grgao/boat/Report/main.tex

% define \title (only used by writelatex.com)
%\title{ECE 455 Capstone Design in Electrical and Computer Engineering \\}
%%%%%%%%%%%%%%%%%%%%%%%%%%%%%%%%%%%%%%%%%%%%%%%%%%%%%%%%%%%%%%%%%%%%%%
% LaTeX Template: Project Titlepage
%
% Source: http://www.howtotex.com
% Date: April 2011
% 
% This is a title page template which be used for articles & reports.
% 
% Feel free to distribute this example, but please keep the referral
% to howtotex.com
% 
%%%%%%%%%%%%%%%%%%%%%%%%%%%%%%%%%%%%%%%%%%%%%%%%%%%%%%%%%%%%%%%%%%%%%%
% How to use writeLaTeX: 
%
% You edit the source code here on the left, and the preview on the
% right shows you the result within a few seconds.
%
% Bookmark this page and share the URL with your co-authors. They can
% edit at the same time!
%
% You can upload figures, bibliographies, custom classes and
% styles using the files menu.
%
% If you're new to LaTeX, the wikibook is a great place to start:
% http://en.wikibooks.org/wiki/LaTeX
%
%%%%%%%%%%%%%%%%%%%%%%%%%%%%%%%%%%%%%%%%%%%%%%%%%%%%%%%%%%%%%%%%%%%%%%
%
% --------------------------------------------------------------------
% Preamble
% --------------------------------------------------------------------
\documentclass[ fontsize=11pt,twoside]{scrartcl}	% KOMA

\usepackage[letterpaper,pdftex]{geometry}	% A4paper margins
\setlength{\oddsidemargin}{5mm}			% Remove 'twosided' indentation
\setlength{\evensidemargin}{5mm}

\usepackage[english]{babel}
\usepackage[protrusion=true,expansion=true]{microtype}	
\usepackage{amsmath,amsfonts,amsthm,amssymb}
\usepackage{graphicx}
\usepackage{pseudocode}
\usepackage{siunitx}				% SI units
\usepackage{hyperref}

\usepackage[utf8]{inputenc}      % Use UTF-8 encoding
\usepackage[T1]{fontenc}         % Use modern font encoding
\usepackage{lmodern}             % Use scalable Latin Modern fonts
\usepackage{microtype}           % Enables font expansion
\usepackage{tikz}
\usepackage{float}
\usepackage{listings}
\usepackage{xcolor}
\usepackage{longtable}

\lstset{
    basicstyle=\ttfamily\small,
    keywordstyle=\color{blue},
    commentstyle=\color{gray},
    stringstyle=\color{orange},
    frame=single,
    columns=flexible,
    breaklines=true
}
\usetikzlibrary{shapes,arrows}

% --------------------------------------------------------------------
% Definitions (do not change this)
% --------------------------------------------------------------------
\newcommand{\HRule}[1]{\rule{\linewidth}{#1}} 	% Horizontal rule

\makeatletter							% Title
\def\printtitle{%						
    {\centering \@title\par}}
\makeatother									

\makeatletter							% Author
\def\printauthor{%					
    {\centering \Large \@author}}				
\makeatother							

% --------------------------------------------------------------------
% Metadata (Change this)
% --------------------------------------------------------------------
\title{	\Large \textsc{ECE 455 Capstone Design in Electrical and Computer Engineering   \\
															Project Report} 	% Subtitle
		 	\\[2.0cm]								% 2cm spacing
			\HRule{2pt} \\						% Upper rule
			\LARGE \textbf{\uppercase{Low-Frequency Electromagnetic Emitting Autonomous Boat for Offshore Plane Wreckage Recovery}}	% Title
			\HRule{2pt} \\ [0.5cm]		% Lower rule + 0.5cm spacing
			\Large \today			% Todays date
		}

 \author{
		Grace Gao\\	
        Gavin McGowan\\
        Miles Gansho\\
		Esh K\\
		Department of Electrical and Computer Engineering\\	
        College of Engineering \\
		University of Wisconsin-Madison\\
        }

\begin{document}
% ------------------------------------------------------------------------------
% Maketitle
% ------------------------------------------------------------------------------
\thispagestyle{empty}		% Remove page numbering on this page

\printtitle					% Print the title data as defined above
  	\vfill
\printauthor				% Print the author data as defined above
\newpage
% ------------------------------------------------------------------------------
% Begin document
% ------------------------------------------------------------------------------
\setcounter{page}{1}		% Set page numbering to begin on this page

%%%%%%%%%%%%%%%
%														%
% 			Main Contents            %
%														%
%%%%%%%%%%%%%%%

\input{Introduction}
\input{BillofMaterials}
\input{Circuit_schem}
\input{Hardware}
\input{Electrical}
\input{Coding}
\input{Operating Instructions}
\input{Troubleshooting} 
\input{FutureWork}

\clearpage
\appendix
\input{appendix}

% ------------------------------------------------------------------------------
% End document
% ------------------------------------------------------------------------------
\end{document}
