grgao/boat/Report/appendix.tex

\section{Isometric Views of all 3D-Printed Parts}

\begin{figure}[htbp]
    \centering
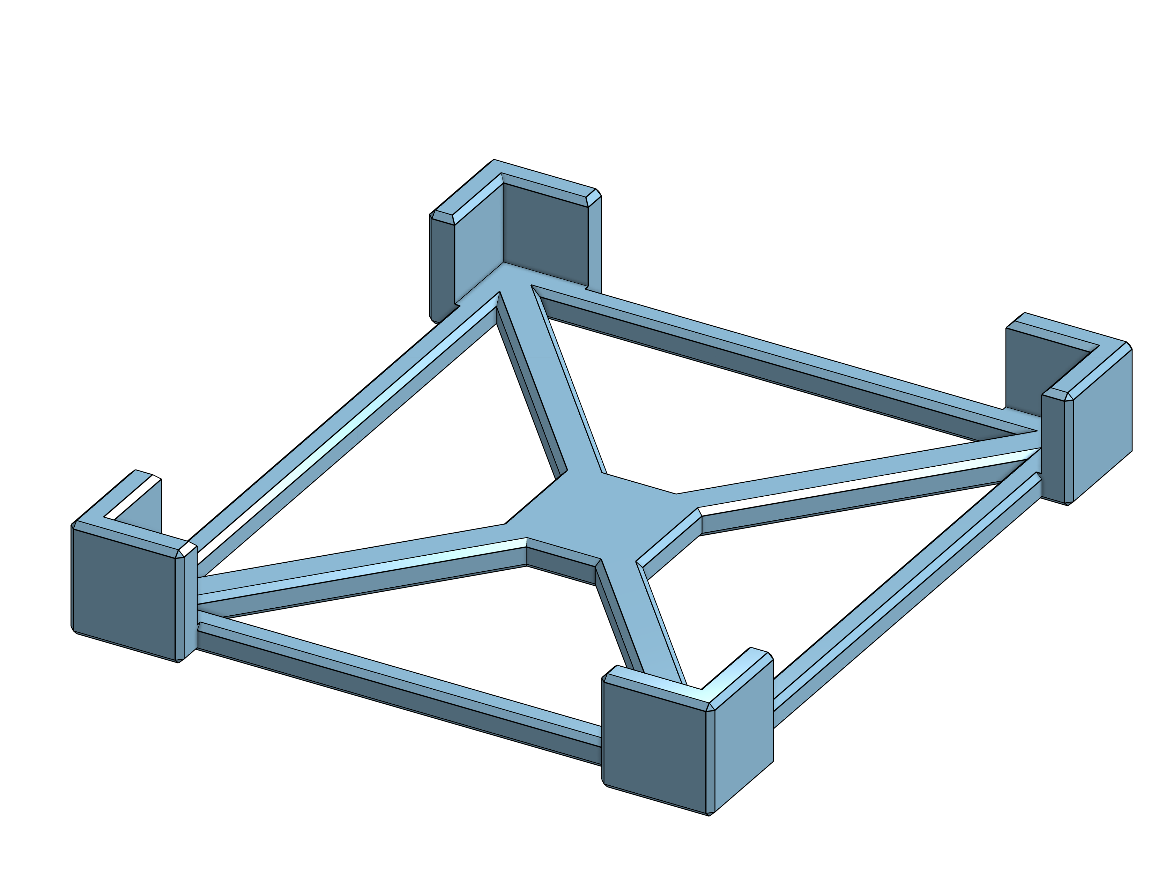
[picture p6: Report/Battery_Base.png]
    
    \caption{Base to hold batteries in place.}
    \label{fig:battery-base}
\end{figure}

\begin{figure}[htbp]
    \centering
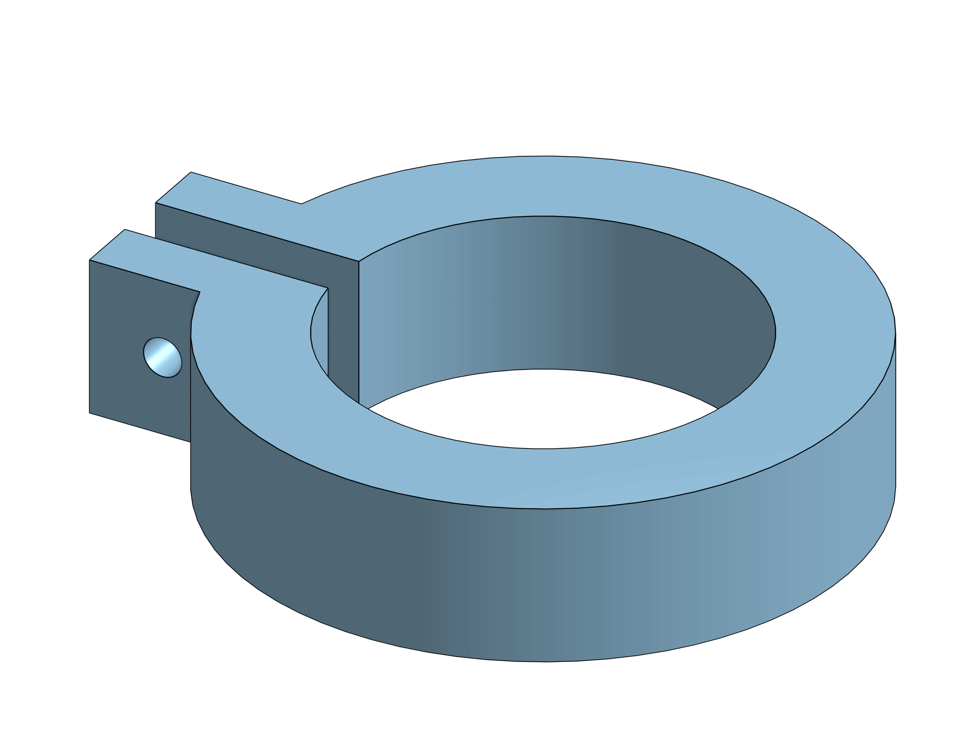
[picture p7: Report/Clamp.png]
    
    \caption{Bushing that clamps to PVC.}
    \label{fig:clamp}
\end{figure}

\begin{figure}[htbp]
    \centering
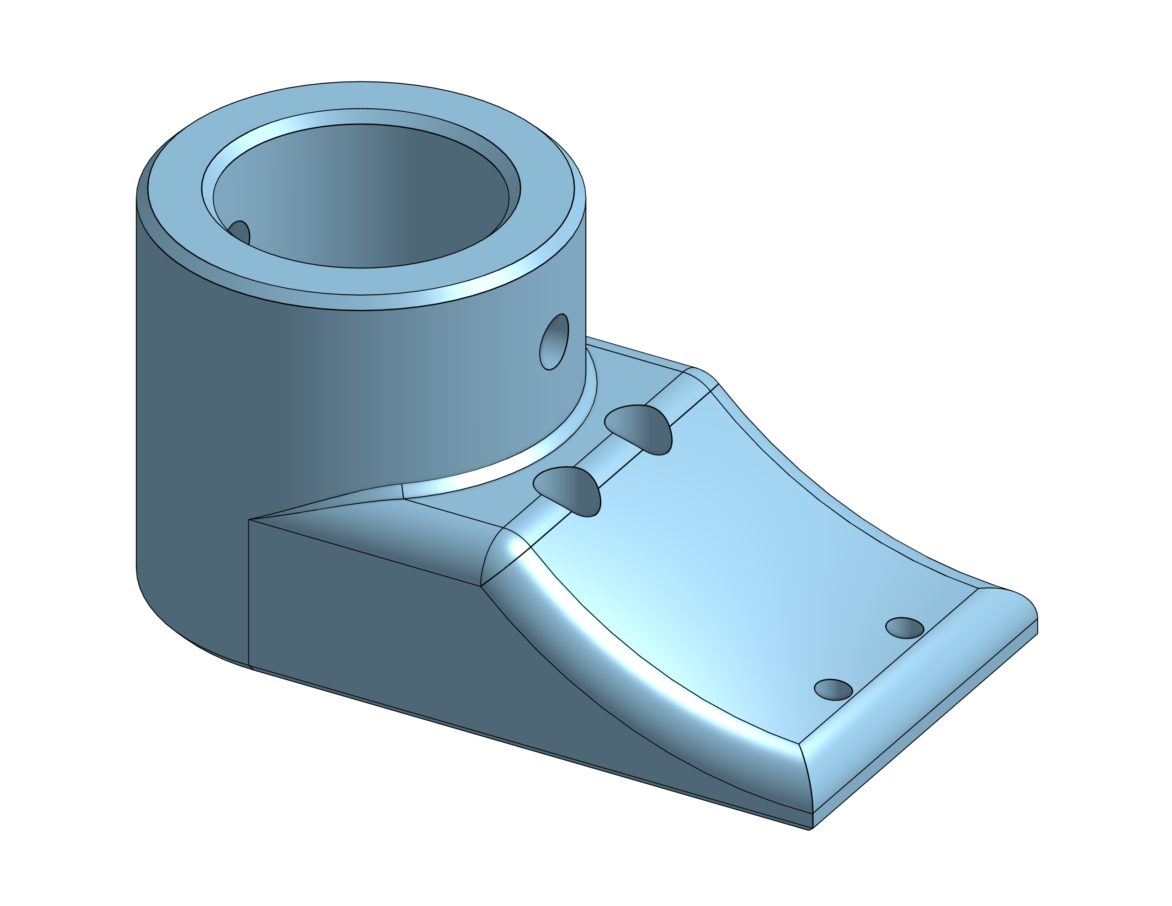
[picture p8: Report/Motor_to_PVC.png]
    
    \caption{Motor to PVC attachment.}
    \label{fig:motor-to-pvc}
\end{figure}

\begin{figure}[htbp]
    \centering
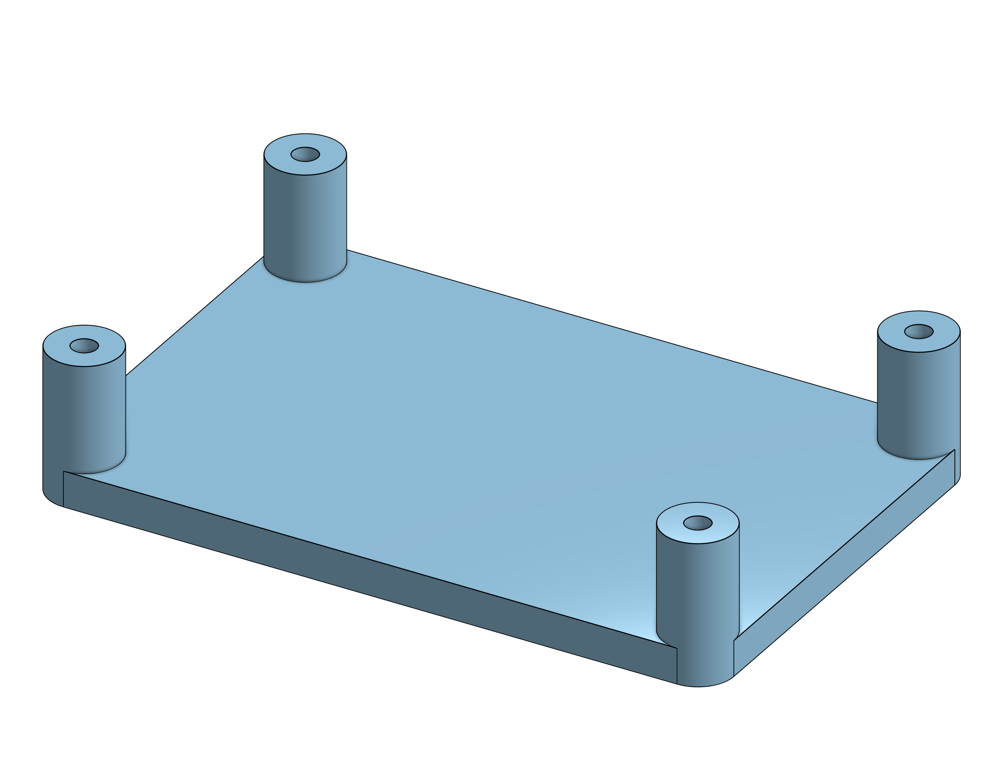
[picture p9: Report/Perfboard_Mounting.png]
    
    \caption{Base for perfboard to mount to with M2 screws.}
    \label{fig:perfboard-mounting}
\end{figure}

\begin{figure}[htbp]
    \centering
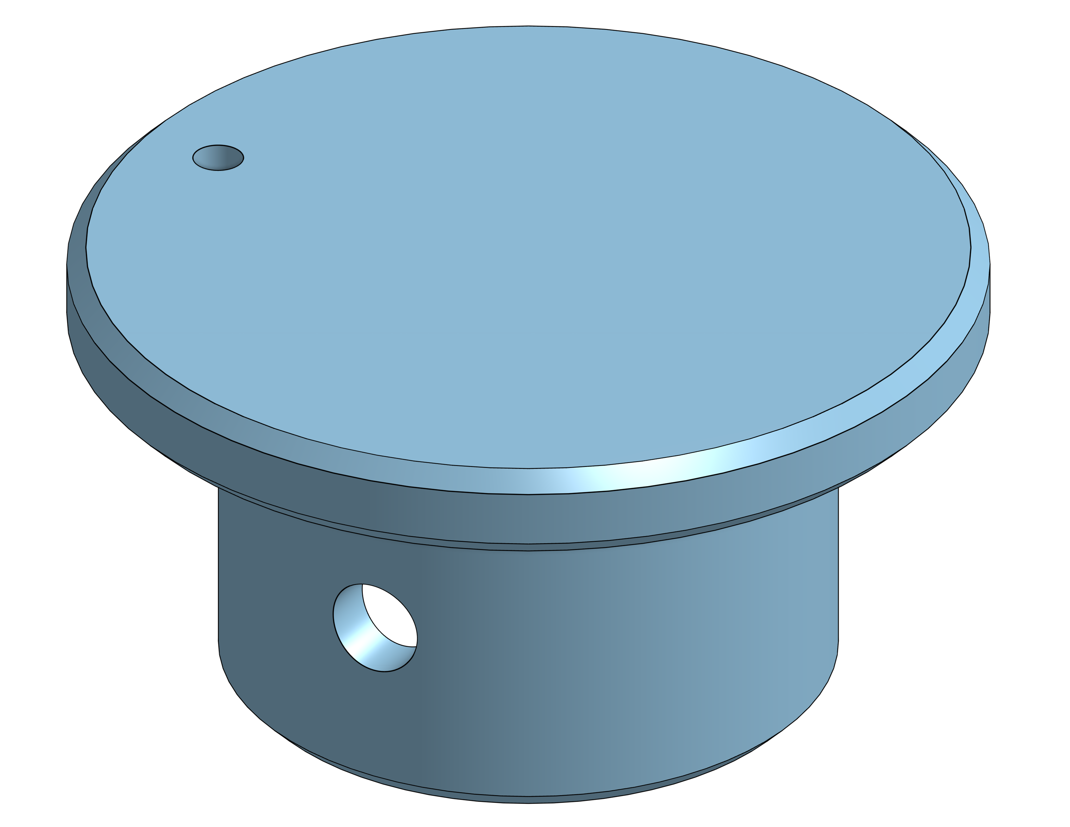
[picture p10: Report/Servo_to_PVC.png]
    
    \caption{Servo to PVC attachment to align axis of rotation.}
    \label{fig:servo-to-pvc}
\end{figure}
