grgao/boat/Report/Simulations and Circuit Board Design.tex

\section{Simulation and Circuit Board Design}
Include URL links to any circuit simulation or PCB design files. You can store them on a folder in OneDrive. \textbf{Please add me as an owner so I can access the files after your account closes.}
