grgao/boat/Report/Power_Diagram.png

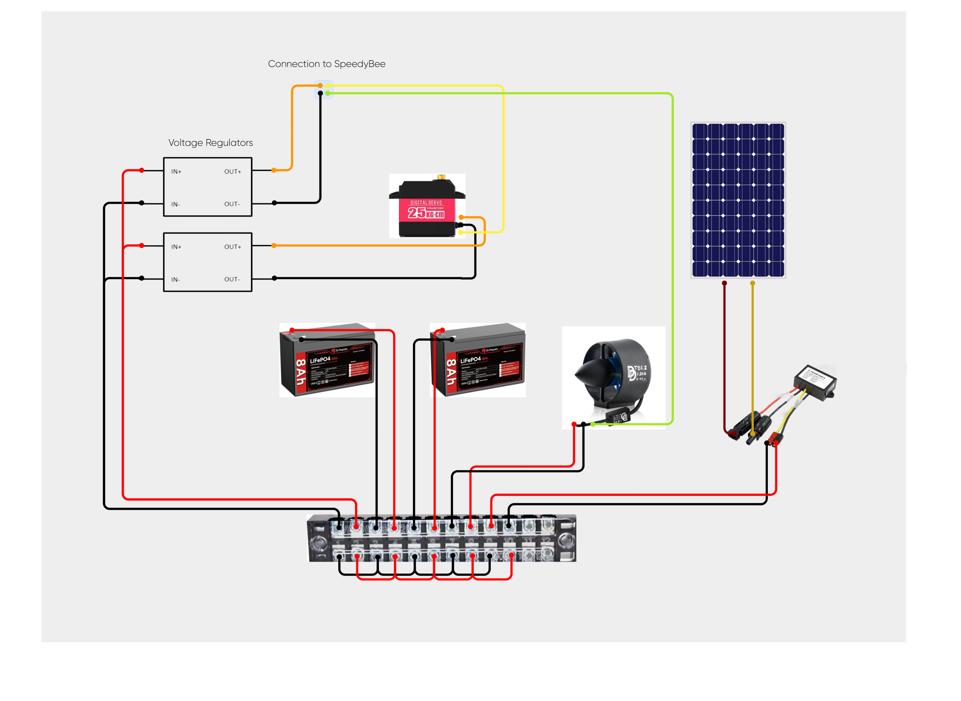
Report/Power_Diagram.png
