grgao/boat/Report/PVC.jpg

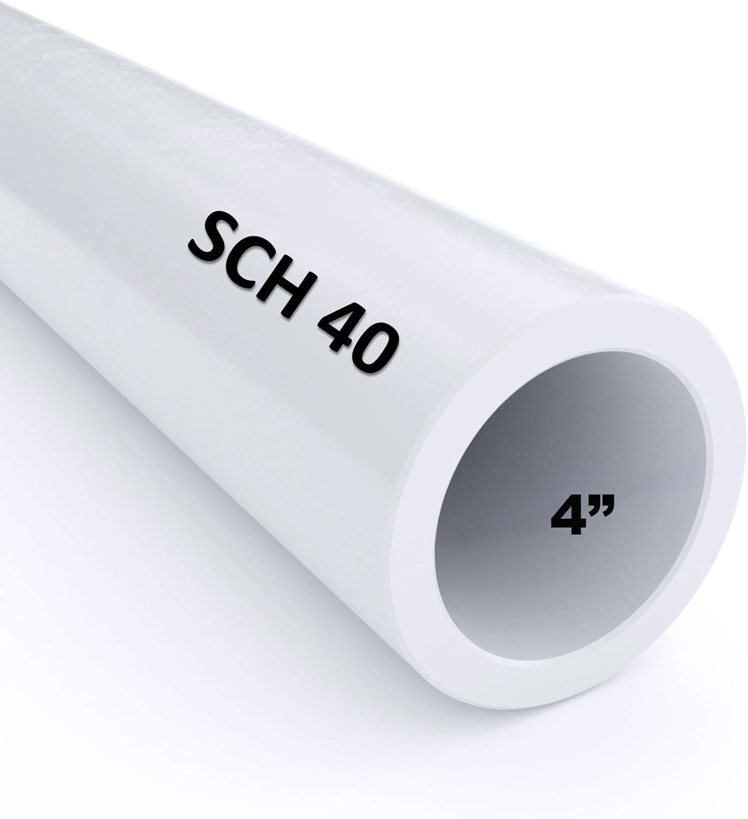
Report/PVC.jpg
