grgao/boat/Report/BillofMaterials.tex

\section{Bill of Materials}
\begin{table}[H]
    \centering
    \begin{tabular}{|l|l|l|l|}
    \hline
        Item & Price/unit & Quantity & Total Price \\ \hline
        18AWG wire & \$0.00 & 702 ft & \$0.00 \\ \hline
        PVC Pipe 1" & \$0.00 & 1 & \$0.00 \\ \hline
        PVC Pipe 4" & \$0.00 & 2 & \$0.00 \\ \hline
        PVC cement & \$0.00 & 1 & \$0.00 \\ \hline
        PVC caps (2 pack) & \$14.99 & 2 & \$29.98 \\ \hline
        Underwater Motor & \$67.52 & 1 & \$67.52 \\ \hline
        Servo & \$13.99 & 1 & \$13.99 \\ \hline
        SpeedyBee & \$65.00 & 1 & \$65.00 \\ \hline
        Amplifier & \$9.00 & 1 & \$9.00 \\ \hline
        Transmitter / Reciever & \$50.00 & 1 & \$50.00 \\ \hline
        100W Solar Panel & \$70.00 & 1 & \$70.00 \\ \hline
        Battery & \$22.00 & 2 & \$44.00 \\ \hline
        MPPT Charger & \$42.00 & 1 & \$42.00 \\ \hline
        Acrylic & \$40.00 & 0 & \$0.00 \\ \hline
        Electronic Box & \$31.00 & 1 & \$31.00 \\ \hline
        Filament Roll & \$20.00 & 1 & \$20.00 \\ \hline
        PolyCarbonate & \$0.00 & 1 & \$0.00 \\ \hline
        Signal Generator & \$7.99 & 1 & \$7.99 \\ \hline
        GPS & \$18.00 & 1 & \$18.00 \\ \hline
        EPS Foam & \$0.00 & 1 & \$0.00 \\ \hline
        1/4" inch bolt  & \$0.00 & 14 & \$0.00 \\ \hline
        1/4" nut & \$0.00 & 20 & \$0.00 \\ \hline
        Washer & \$0.10 & 20 & \$2.00 \\ \hline
        1/2" Fiber glass composite rods & \$0.00 & 4 & \$0.00 \\ \hline
        HDF wood & \$3.75 & 1 & \$3.75 \\ \hline
        M3 Screw & \$0.35 & 2 & \$0.70 \\ \hline
        Long bolt  & \$0.00 & 4 & \$0.00 \\ \hline
        L7805CV & \$0.00 & 2 & \$0.00 \\ \hline
        Capacitors & \$0.00 & 12 & \$0.00 \\ \hline
        WM8672-ND & \$1.36 & 1 & \$1.36 \\ \hline
        732-10955-ND & \$0.36 & 2 & \$0.72 \\ \hline
        296-43663-1-ND & \$0.90 & 2 & \$1.80 \\ \hline
        445-174398-1-ND & \$0.32 & 2 & \$0.64 \\ \hline
        Total Price of ASV & ~ & ~ & \$479.45 \\ \hline
    \end{tabular}
\end{table}

The bill of materials includes what is actually used on the ASV. This doesn't include the cost of a few purchased items that were never used, such as an acrylic base. It also does not include the costs of materials that were given to us for free, such as the PVC pipe. An Excel sheet of the BOM can be found in the repository, including links to all purchased items. The total cost of the ASV is \$479.45, which is under the \$500 budget.
