grgao/boat/Report/BOM with Links.xlsx

Item | Price/unit | Quantity | Total Price | Link
18AWG wire | $0.00 | 702 ft | $0.00 | https://www.remingtonindustries.com/hook-up-wire/hook-up-wire-18-awg-stranded-solid-10-colors-7-sizes-available/
PVC Pipe 1" | $0.00 | 1 | $0.00 | Acquired at Makerspace
PVC Pipe 4" | $0.00 | 2 | $0.00 | Acquired at Makerspace
PVC cement | $0.00 | 1 | $0.00 | Acquired at Makerspace
PVC caps | $14.99 | 2 | $29.98 | https://www.homedepot.com/p/NDS-PVC-S-D-Cap-4-in-4P06/100172701
Underwater Motor | $67.52 | 1 | $67.52 | https://www.amazon.com/dp/B09BVKKKTJ?ref_=ppx_hzsearch_conn_dt_b_fed_asin_title_1
Servo | $13.99 | 1 | $13.99 | https://www.amazon.com/DIAMONDDYNAMICS-Underwater-bi-Directional-Photography-Exploration/dp/B09BVKB3KD
SpeedyBee | $65.00 | 1 | $65.00 | https://www.getfpv.com/speedybee-f405-v4-stack-f4-v4-fc-55a-blheli-s-esc-30x30.html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
Amplifier | $9.00 | 1 | $9.00 | https://www.amazon.com/EPLZON-MPU-6050-Accelerometer-Gyroscope-Converter/dp/B09TVYVC6X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
Transmitter / Reciever | $50.00 | 1 | $50.00 | https://www.amazon.com/dp/B0744DPPL8?ref_=ppx_hzsearch_conn_dt_b_fed_asin_title_1
100W Solar Panel | $70.00 | 1 | $70.00 | https://www.amazon.com/MARBERO-30W-Portable-Solar-Panel-Foldable-Solar-Charger-Generator-Camping-Outdoor-Adventures/dp/B0C58KPMVT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
Battery | $22.00 | 2 | $44.00 | https://www.amazon.com/dp/B0CLGZMHVG?ref_=ppx_hzsearch_conn_dt_b_fed_asin_title_2&th=1
MPPT Charger | $42.00 | 1 | $42.00 | https://www.amazon.com/dp/B087ZSY8CR?ref_=ppx_hzsearch_conn_dt_b_fed_asin_title_1
Electronic Box | $31.00 | 1 | $31.00 | https://www.amazon.com/dp/B08TRQBMCX?ref_=ppx_hzsearch_conn_dt_b_fed_asin_title_1
Filament Roll | $20.00 | 1 | $20.00 | https://www.amazon.com/eSUN-Filament-Dimensional-Accuracy-Printing/dp/B0BN4Y1G2S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
PolyCarbonate | $0.00 | 1 | $0.00 | Acquired at Makerspace
Signal Generator | $7.99 | 1 | $7.99 | https://www.amazon.com/NOYITO-Generator-Frequency-Triangle-Waveform/dp/B07BJHXML4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
GPS | $18.00 | 1 | $18.00 | https://www.amazon.com/dp/B0CB5N8RQ8?ref_=ppx_hzod_title_dt_b_fed_asin_title_0_0
EPS Foam | $0.00 | 1 | $0.00 | Acquired at Makerspace
1/4 inch bolt | $0.00 | 14 | $0.00 | Acquired at Makerspace
1/4 nut | $0.00 | 20 | $0.00 | Acquired at Makerspace
Washer | $0.10 | 20 | $2.00 | Acquired at Makerspace
1/2" Fiber glass composite rods | $0.00 | 4 | $0.00 | Acquired at Makerspace
HDF wood | $3.75 | 1 | $3.75 | Acquired at Makerspace
M3 Screw | $0.35 | 2 | $0.70 | Acquired at Makerspace
Long bolt | $0.00 | 4 | $0.00 | Acquired at Engineer Center Building
L7805CV | $0.00 | 2 | $0.00 | Acquired at Makerspace/Thompson |  | Acquired at Makerspace/Thompson
Capacitors | $0.00 | 12 | $0.00 | Acquired at Makerspace/Thompson |  | Acquired at Makerspace/Thompson
WM8672-ND | $1.36 | 1 | $1.36 | https://www.digikey.com/en/products/detail/molex/1050570001/3045207 | yes | https://www.digikey.com/en/products/detail/molex/1050570001/3045207
732-10955-ND | $0.36 | 2 | $0.72 | https://www.digikey.com/en/products/detail/w%C3%BCrth-elektronik/691137710002/6644051 | yes | https://www.digikey.com/en/products/detail/w%C3%BCrth-elektronik/691137710002/6644051
296-43663-1-ND | $0.90 | 2 | $1.80 | https://www.digikey.com/en/products/detail/texas-instruments/TPS563200DDCR/5034343 | yes | https://www.digikey.com/en/products/detail/texas-instruments/TPS563200DDCR/5034343
445-174398-1-ND | $0.32 | 2 | $0.64 | https://www.digikey.com/en/products/detail/tdk-corporation/VLS5045EX-3R3N/5286683 | yes | https://www.digikey.com/en/products/detail/tdk-corporation/VLS5045EX-3R3N/5286683
Total Price of Boat |  |  | $479.45
