grgao/boat/STEP Files/Solar Panel Bracket pair.step

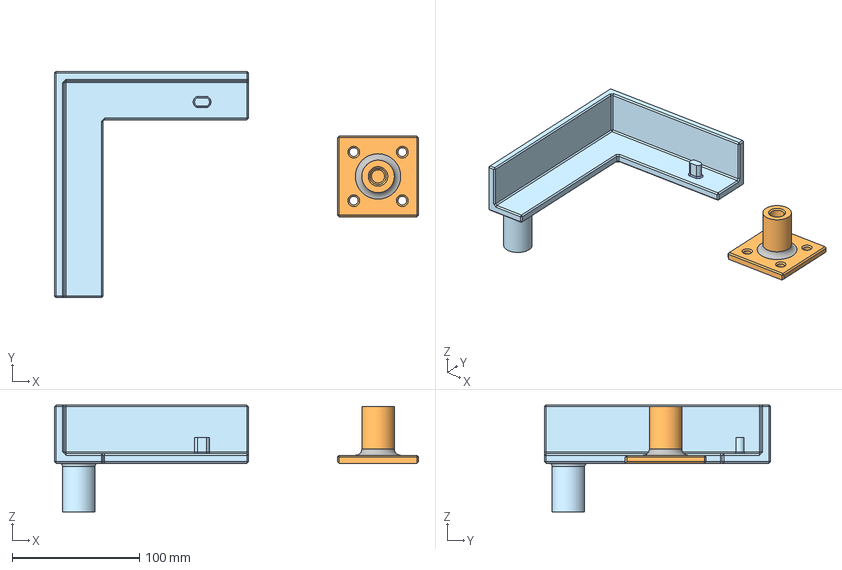
[picture p21: CAD file, 2025-05-11]
STEP Files/Solar Panel Bracket pair.step
285.8 x 177.8 x 83.8 mm
