grgao/boat/STEP Files/Protoboard Mount.step

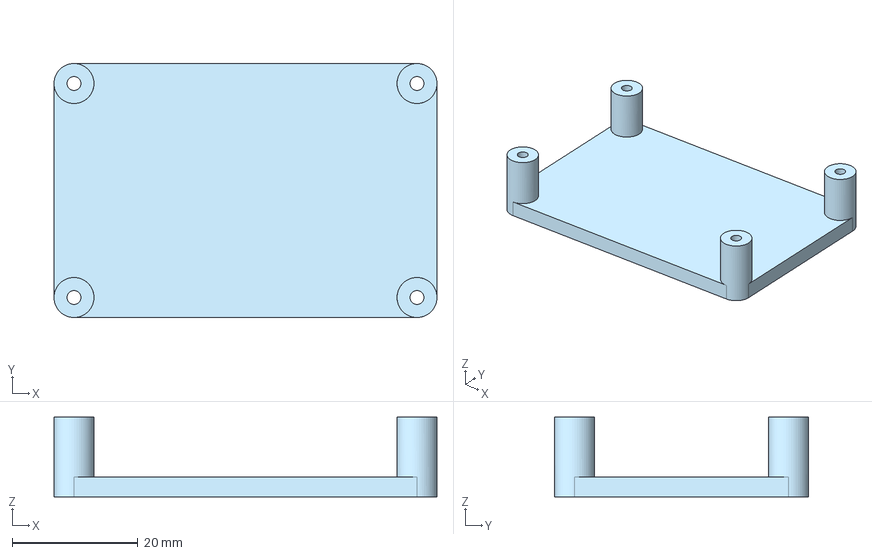
[picture p22: CAD file, 2025-05-11]
STEP Files/Protoboard Mount.step
60.9 x 40.4 x 12.7 mm
