grgao/boat/STEP Files/Servo to PVC.step

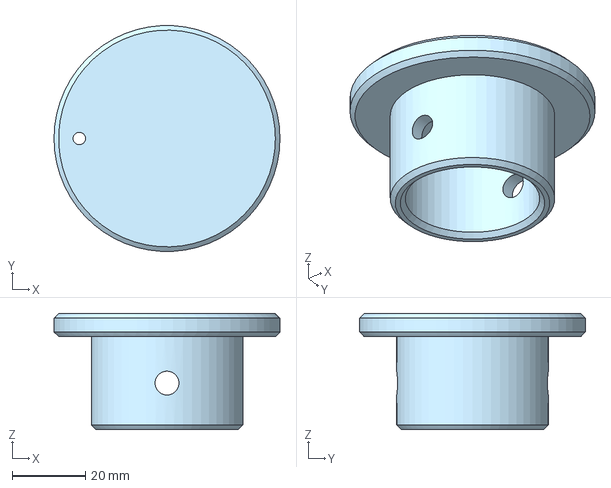
[picture p23: CAD file, 2025-05-11]
STEP Files/Servo to PVC.step
61.8 x 61.8 x 31.8 mm
