grgao/boat/STEP Files/Motor to PVC.step

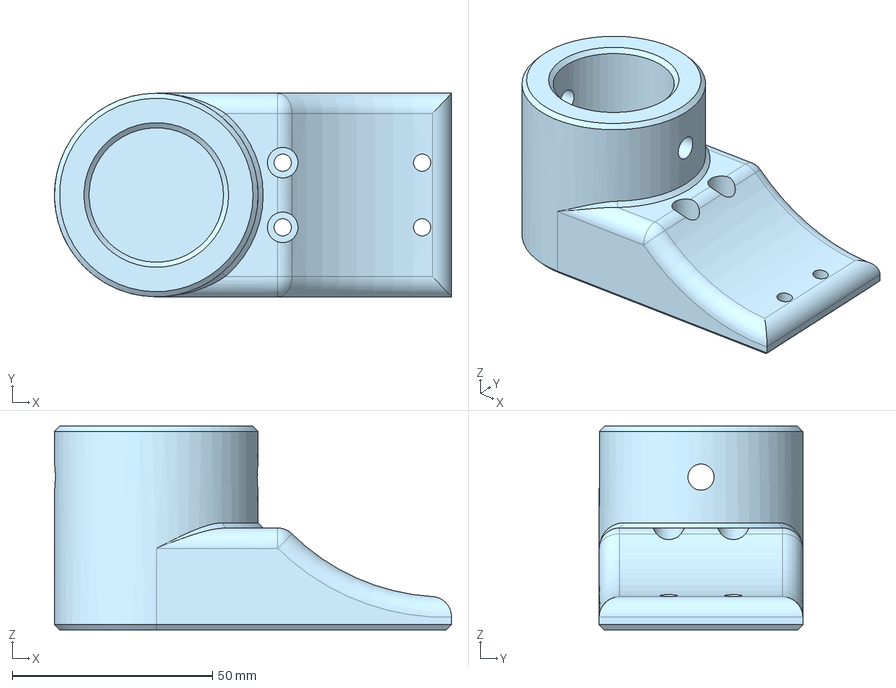
[picture p24: CAD file, 2025-05-11]
STEP Files/Motor to PVC.step
99.1 x 50.8 x 50.8 mm
