grgao/boat/STEP Files/Battery Mount.step

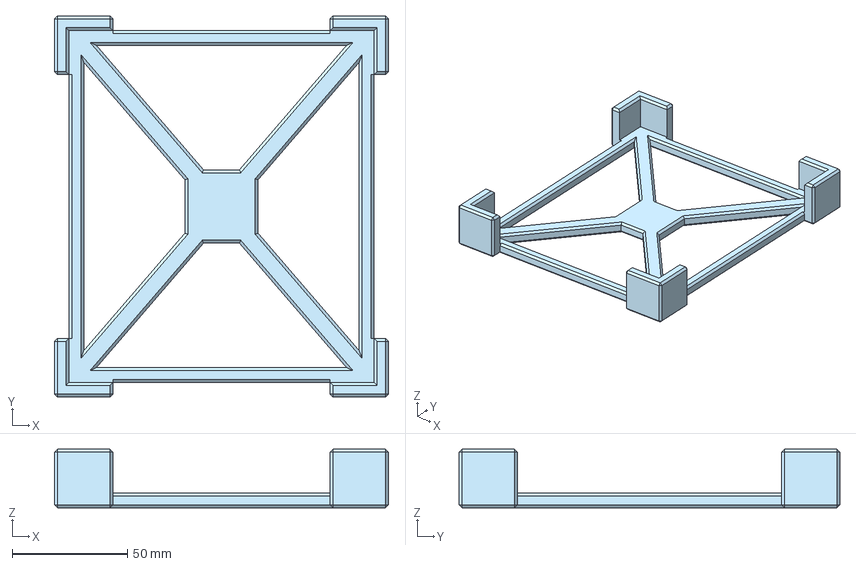
[picture p25: CAD file, 2025-05-11]
STEP Files/Battery Mount.step
144.8 x 165.1 x 25.4 mm
