grgao/boat/STEP Files/Flange and Lid.step

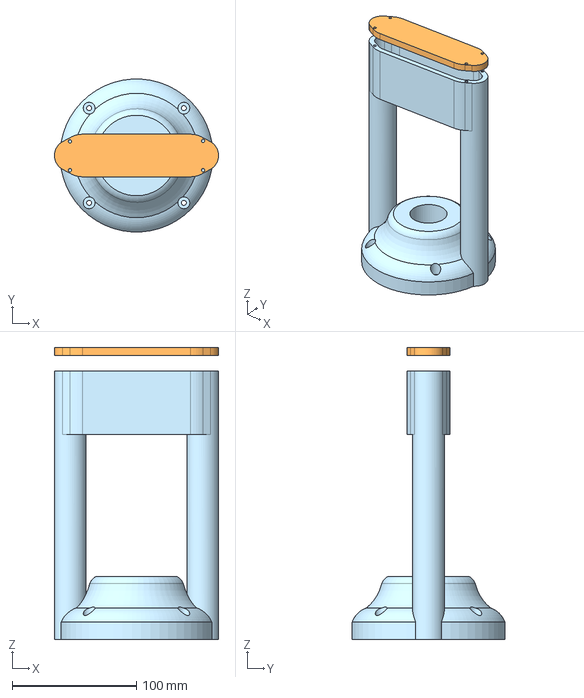
[picture p26: CAD file, 2025-05-11]
STEP Files/Flange and Lid.step
132.1 x 123.0 x 234.9 mm
