grgao/boat/STEP Files/Bushing.step

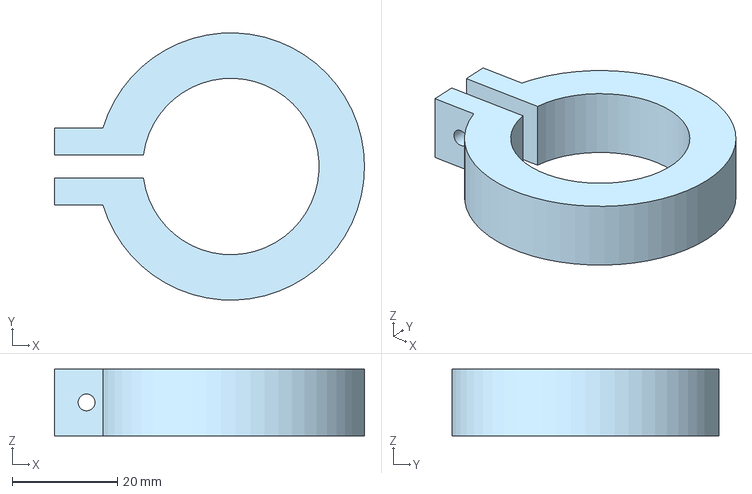
[picture p27: CAD file, 2025-05-11]
STEP Files/Bushing.step
58.9 x 50.8 x 12.7 mm
