grgao/boat/Report/Flange_Assembly.png

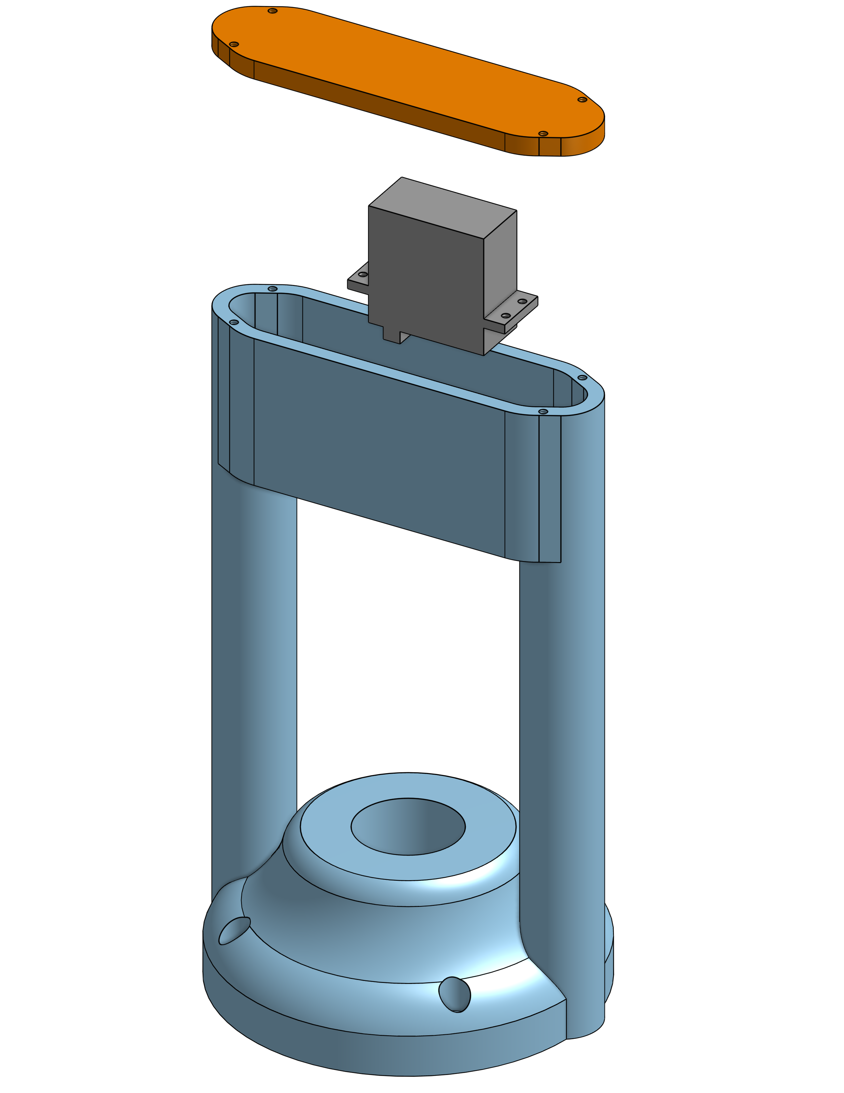
Report/Flange_Assembly.png
