grgao/boat/Report/Solar_Panel_Assembly.png

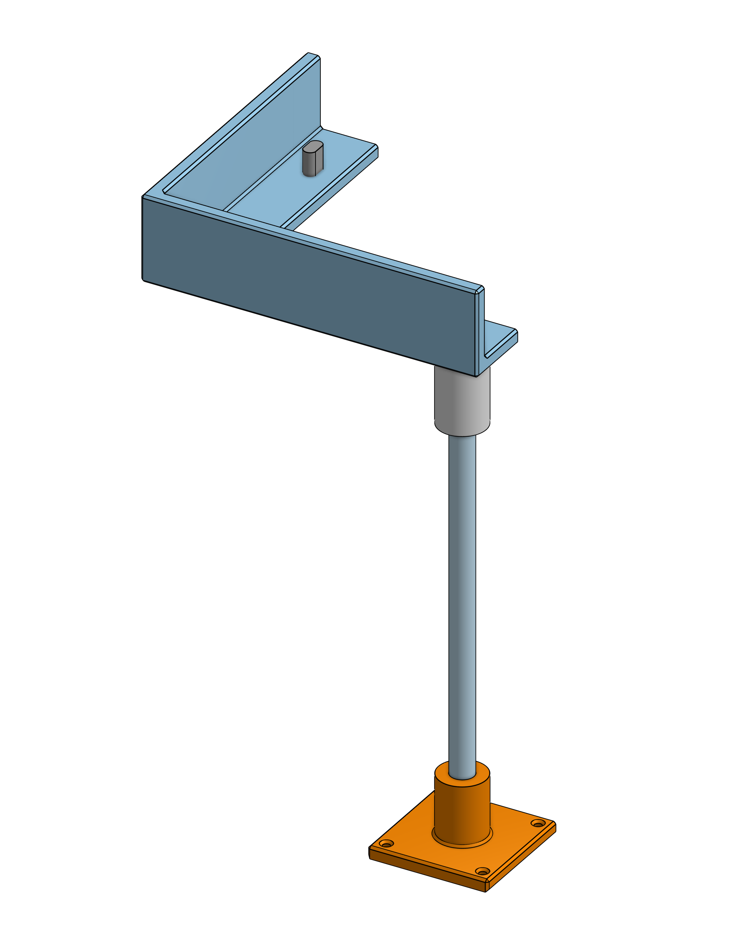
Report/Solar_Panel_Assembly.png
