grgao/boat/Report/DC-DC converter.pdf

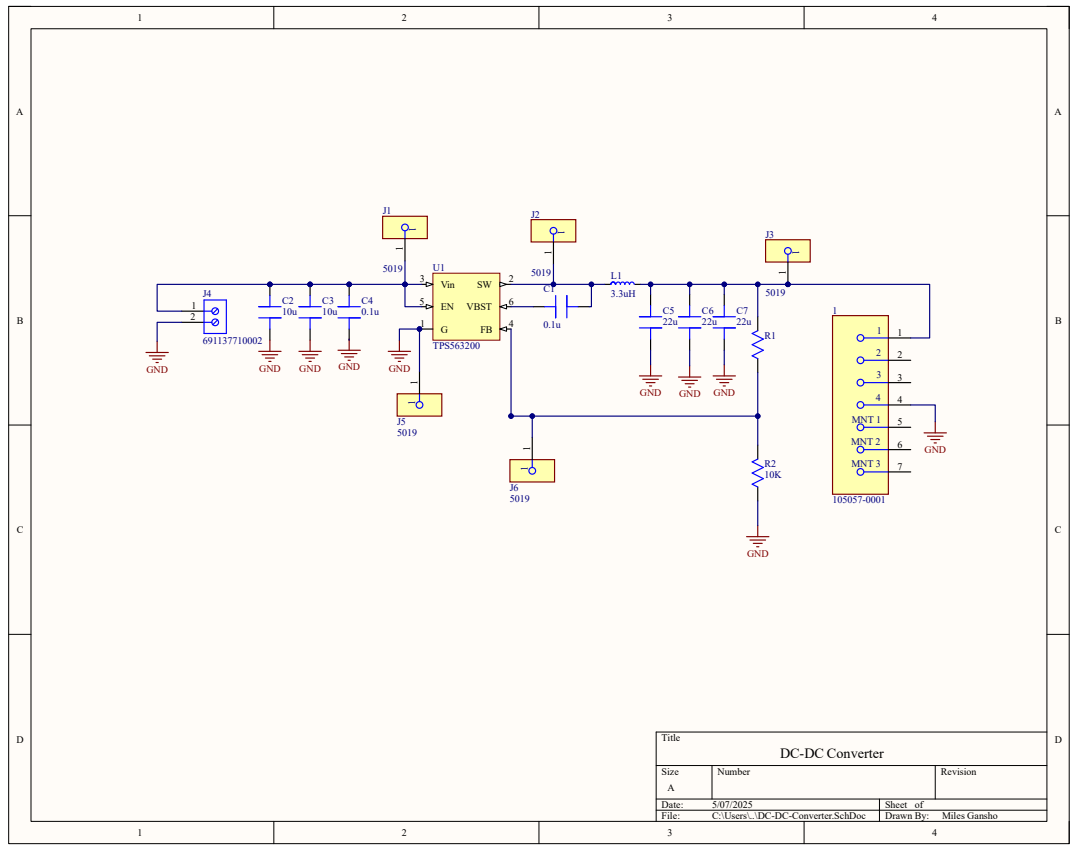
[picture p31: page 1]
