grgao/boat/(commit log)

2025-02-14 make motor run
2025-02-28 add user input motor control
2025-03-05 add servo code
2025-03-05 revert motor
2025-05-06 add speedybee schematic
2025-05-06 added 3D printed section on hardware
2025-05-06 couple of hardware changes plus updating bouyancy calcs
2025-05-07 added assembly views
2025-05-08 updated a couple things, combined sections in hardware
2025-05-09 added power diagram
2025-05-09 added power diagram and writing to electrical
2025-05-09 updated magnetic moment equation in electrical
2025-05-09 cleaned up a bunch and ready to submit
    [BOM with Links.xlsx]
2025-05-11 added step files
    [Battery Mount.step, Bushing.step, Flange and Lid.step, Motor to PVC.step, Protoboard Mount.step, Servo to PVC.step, Solar Panel Bracket pair.step]
